LegendLuhar/Drone/README.md

# ELEC 327 Drone Final Project

This repository contains all necessary files for the ELEC 327 Final Project (Custom Drone)
