LegendLuhar/Drone/Simon_README.md

# Simon Accelerometer/Drone

Simon Accelerometer code - will be used as the skeleton for implementing basic motor actuation.
