LegendLuhar/Drone/REALdronePCB/REALdronePCB.kicad_pcb

## KiCad design REALdronePCB/REALdronePCB.kicad_pcb (2026-04-27)

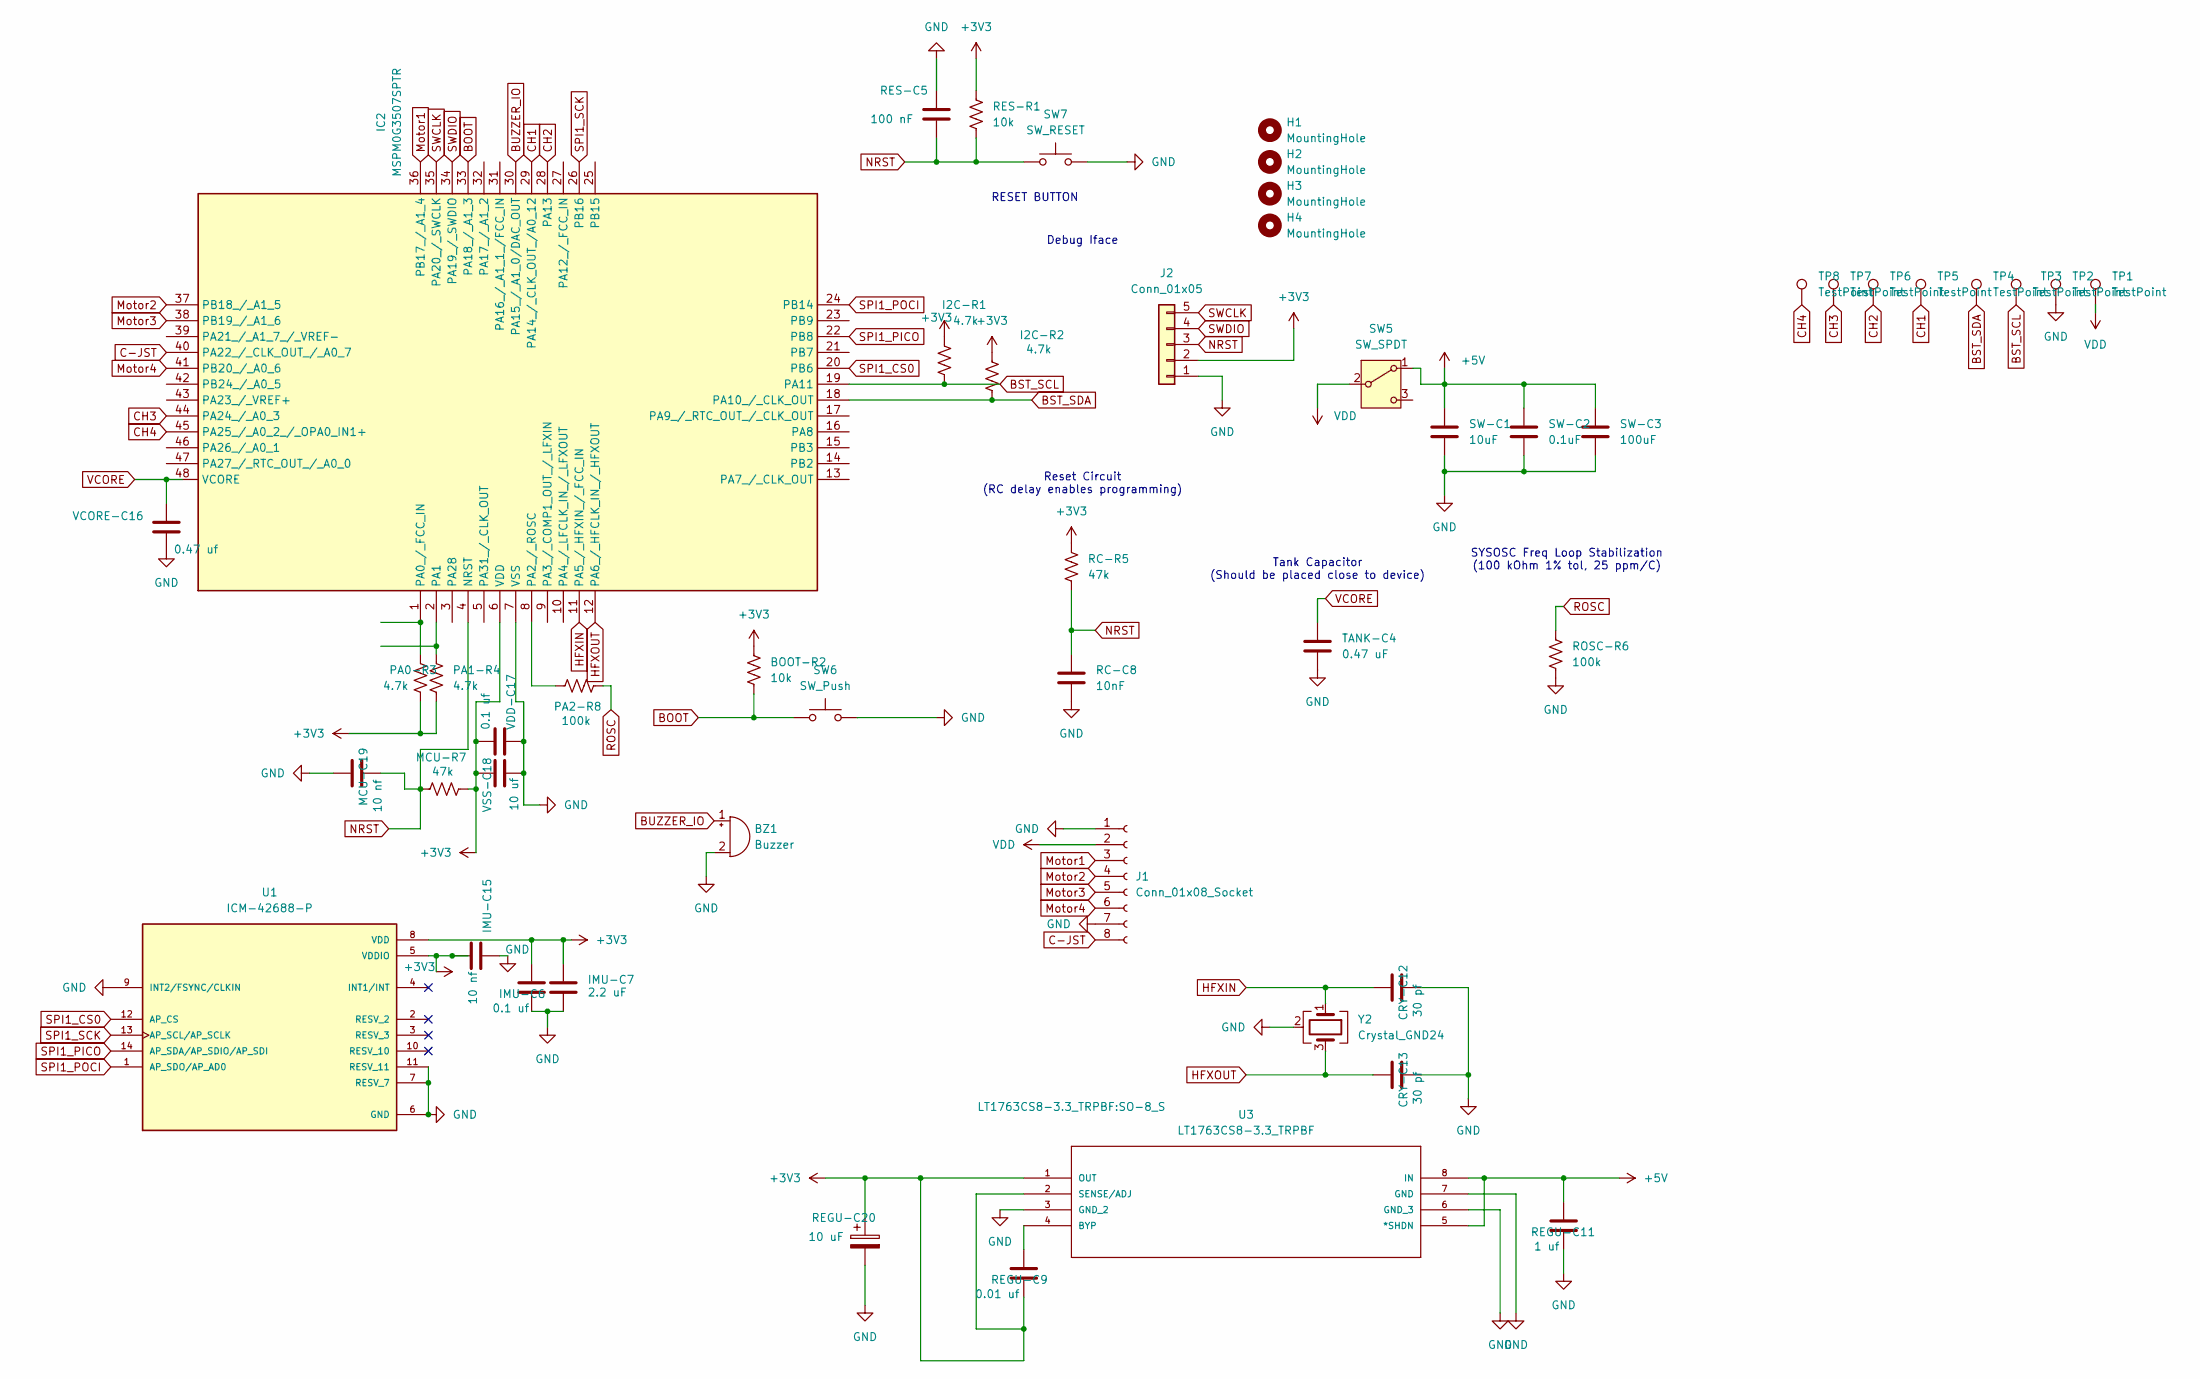
[picture p1: schematic REALdronePCB.kicad_sch]

Parts:
BOOT-R2: 10k; R_0805_2012Metric_Pad1.20x1.40mm_HandSolder
BZ1: Buzzer; Buzzer_Murata_PKLCS1212E; LCSC Part # C113159
CRY-C12, CRY-C13: 30 pf; C_1206_3216Metric_Pad1.33x1.80mm_HandSolder
H1, H2, H3, H4: MountingHole; DroneTHTPad
I2C-R1, I2C-R2: 4.7k; R_0805_2012Metric_Pad1.20x1.40mm_HandSolder; LCSC Part # C105579
IC2: MSPM0G3507SPTR; QFP50P900X900X160-48N; Mouser Part Number 595-MSPM0G3507SPTR
IMU-C6: 0.1 uf; C_1206_3216Metric_Pad1.33x1.80mm_HandSolder
IMU-C7: 2.2 uF; C_1206_3216Metric_Pad1.33x1.80mm_HandSolder
IMU-C15: 10 nf; C_1206_3216Metric_Pad1.33x1.80mm_HandSolder
J1: Conn_01x08_Socket; JST_SH_SM08B-SRSS-TB_1x08-1MP_P1.00mm_Horizontal
J2: Conn_01x05; PinHeader_1x05_P2.54mm_Horizontal; LCSC Part # C492413
MCU-C19: 10 nf; C_1206_3216Metric_Pad1.33x1.80mm_HandSolder
MCU-R7: 47k; R_0805_2012Metric_Pad1.20x1.40mm_HandSolder
PA0-R3, PA1-R4: 4.7k; R_0805_2012Metric_Pad1.20x1.40mm_HandSolder
PA2-R8: 100k; R_0805_2012Metric_Pad1.20x1.40mm_HandSolder
RC-C8: 10nF; C_1206_3216Metric_Pad1.33x1.80mm_HandSolder; LCSC Part # C15195
RC-R5: 47k; R_0805_2012Metric_Pad1.20x1.40mm_HandSolder; LCSC Part # C105579
REGU-C9: 0.01 uf; C_1206_3216Metric_Pad1.33x1.80mm_HandSolder
REGU-C11: 1 uf; C_1206_3216Metric_Pad1.33x1.80mm_HandSolder
REGU-C20: 10 uF; C_0805_2012Metric_Pad1.18x1.45mm_HandSolder
RES-C5: 100 nF; C_1206_3216Metric_Pad1.33x1.80mm_HandSolder
RES-R1: 10k; R_0805_2012Metric_Pad1.20x1.40mm_HandSolder
ROSC-R6: 100k; R_0805_2012Metric_Pad1.20x1.40mm_HandSolder; LCSC Part # C60491
SW5: SW_SPDT; SW_EG1270; MPN C20611678; LCSC Part # C20611678
SW6: SW_Push; SW_SPST_B3U-1000P
SW7: SW_RESET; SW_SPST_B3U-1000P
SW-C1: 10uF; C_0603_1608Metric; LCSC Part # C19702
SW-C2: 0.1uF; C_0603_1608Metric_Pad1.08x0.95mm_HandSolder; LCSC Part # C1591
SW-C3: 100uF; C_1206_3216Metric; LCSC Part # C15008
TANK-C4: 0.47 uF; C_1206_3216Metric_Pad1.33x1.80mm_HandSolder; LCSC Part # C13967
TP1, TP2, TP3, TP4, TP5, TP6, TP7, TP8: TestPoint; TestPoint_Pad_1.0x1.0mm
U1: ICM-42688-P; LGA-14_3x2.5mm_P0.5mm_LayoutBorder3x4y; PARTREV 1.2
U3: LT1763CS8-3.3_TRPBF; SO-8_S; MANUFACTURER_PART_NUMBER lt1763cs8
VCORE-C16: 0.47 uf; C_1206_3216Metric_Pad1.33x1.80mm_HandSolder
VDD-C17: 0.1 uf; C_1206_3216Metric_Pad1.33x1.80mm_HandSolder
VSS-C18: 10 uf; C_1206_3216Metric_Pad1.33x1.80mm_HandSolder
Y2: Crystal_GND24; Crystal_SMD_5032-4Pin_5.0x3.2mm

Connections:
+3V3: BOOT-R2.1, I2C-R1.2, I2C-R2.2, IC2.6 (VDD), IMU-C6.1, IMU-C7.1, IMU-C15.1, J2.2, MCU-R7.2, PA0-R3.2, PA1-R4.2, RC-R5.2, REGU-C9.2, REGU-C20.1, RES-R1.1, U1.5 (VDDIO), U1.8 (VDD), U3.1 (OUT), U3.2 (SENSE/ADJ), VDD-C17.1, VSS-C18.1
+5V: REGU-C11.1, SW5.1 (A), SW-C1.1, SW-C2.1, SW-C3.1, U3.5 (*SHDN), U3.8 (IN)
BOOT: BOOT-R2.2, IC2.33 (PA18_/_A1_3), SW6.1
BST_SCL: I2C-R1.1, IC2.19 (PA11), TP3.1 (1_1)
BST_SDA: I2C-R2.1, IC2.18 (PA10_/_CLK_OUT), TP4.1 (1_1)
BUZZER_IO: BZ1.1 (+), IC2.30 (PA15_/_A1_0/DAC_OUT)
C-JST: IC2.40 (PA22_/_CLK_OUT_/_A0_7), J1.8
CH1: IC2.29 (PA14_/_CLK_OUT_/A0_12), TP5.1 (1_1)
CH2: IC2.28 (PA13), TP6.1 (1_1)
CH3: IC2.44 (PA24_/_A0_3), TP7.1 (1_1)
CH4: IC2.45 (PA25_/_A0_2_/_OPA0_IN1+), TP8.1 (1_1)
GND: BZ1.2 (-), CRY-C12.2, CRY-C13.2, IC2.7 (VSS), IMU-C6.2, IMU-C7.2, IMU-C15.2, J1.1, J1.7, J2.1, MCU-C19.1, RC-C8.2, REGU-C11.2, REGU-C20.2, RES-C5.1, ROSC-R6.1, SW6.2, SW7.2, SW-C1.2, SW-C2.2, SW-C3.2, TANK-C4.2, TP2.1 (1_1), U1.6 (GND), U1.7 (RESV_7), U1.9 (INT2/FSYNC/CLKIN), U1.11 (RESV_11), U3.3 (GND_2), U3.6 (GND_3), U3.7 (GND), VCORE-C16.1, VDD-C17.2, VSS-C18.2, Y2.2 (G), Y2.4 (G)
HFXIN: CRY-C12.1, IC2.11 (PA5_/_HFXIN_/_FCC_IN), Y2.1
HFXOUT: CRY-C13.1, IC2.12 (PA6_/_HFCLK_IN_/_HFXOUT), Y2.3
Motor1: IC2.36 (PB17_/_A1_4), J1.3
Motor2: IC2.37 (PB18_/_A1_5), J1.4
Motor3: IC2.38 (PB19_/_A1_6), J1.5
Motor4: IC2.41 (PB20_/_A0_6), J1.6
NRST: IC2.4 (NRST), J2.3, MCU-C19.2, MCU-R7.1, RC-C8.1, RC-R5.1, RES-C5.2, RES-R1.2, SW7.1
unnamed: IC2.1 (PA0_/_FCC_IN), PA0-R3.1
unnamed: IC2.2 (PA1), PA1-R4.1
unnamed: IC2.8 (PA2_/_ROSC), PA2-R8.1
unnamed: REGU-C9.1, U3.4 (BYP)
ROSC: PA2-R8.2, ROSC-R6.2
SPI1_CS0: IC2.20 (PB6), U1.12 (AP_CS)
SPI1_PICO: IC2.22 (PB8), U1.14 (AP_SDA/AP_SDIO/AP_SDI)
SPI1_POCI: IC2.24 (PB14), U1.1 (AP_SDO/AP_AD0)
SPI1_SCK: IC2.26 (PB16), U1.13 (AP_SCL/AP_SCLK)
SWCLK: IC2.35 (PA20_/_SWCLK), J2.5
SWDIO: IC2.34 (PA19_/_SWDIO), J2.4
VCORE: IC2.48 (VCORE), TANK-C4.1, VCORE-C16.2
VDD: J1.2, SW5.2 (B), TP1.1 (1_1)

Notes on the sheet:
RESET BUTTON
SYSOSC Freq Loop Stabilization (100 kOhm 1% tol, 25 ppm/C)
Reset Circuit (RC delay enables programming)
Debug Iface
Tank Capacitor (Should be placed close to device)

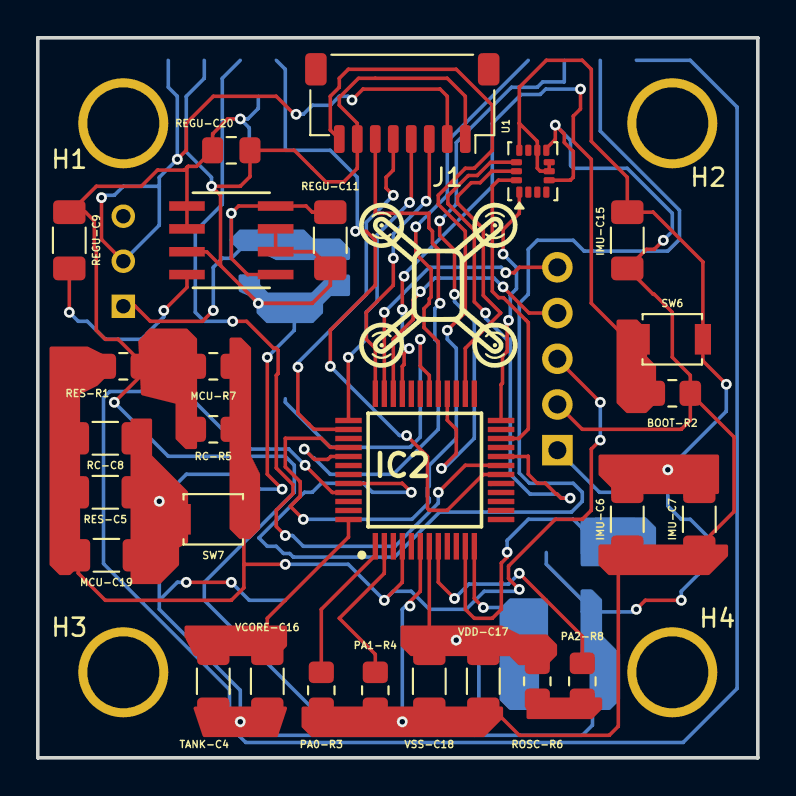
[picture p2: board REALdronePCB.kicad_pcb from above]

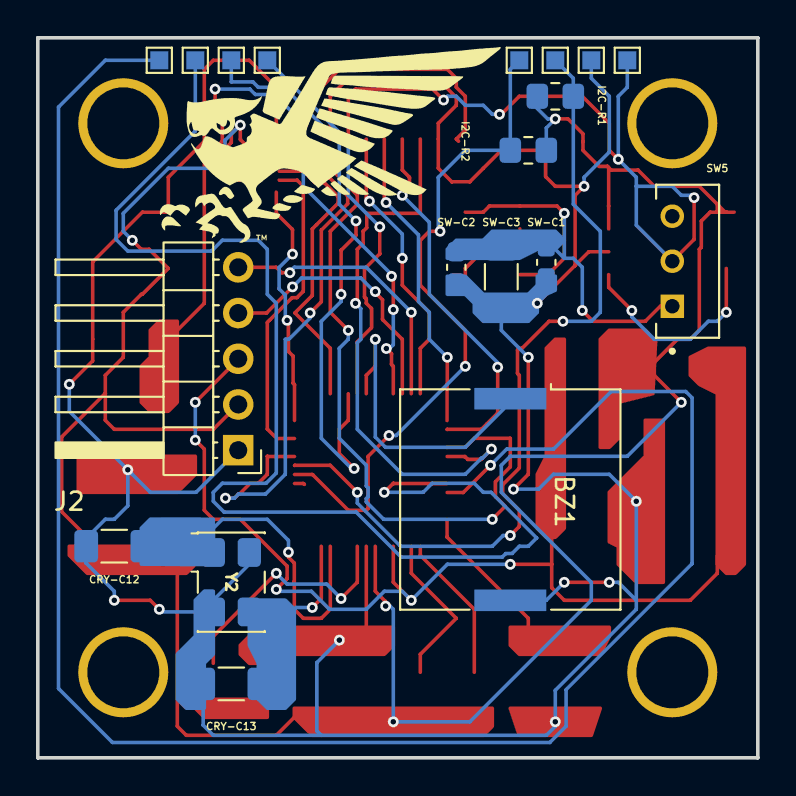
[picture p3: board REALdronePCB.kicad_pcb from below]

Board: 2 copper layers, 40.0 x 40.0 mm, 50 parts (19 on the bottom side), 32 nets.
