LegendLuhar/Drone/(commit log)

2026-04-25 PCB Added
    Should be the final rendition of the PCB
    [REALdronePCB-B_Cu.gbr, REALdronePCB-B_Mask.gbr, REALdronePCB-B_Paste.gbr, REALdronePCB-B_Silkscreen.gbr, REALdronePCB-Edge_Cuts.gbr, REALdronePCB-F_Cu.gbr, REALdronePCB-F_Mask.gbr, REALdronePCB-F_Paste.gbr]
2026-04-27 FixedPCB
    This is the final version.
    [REALdronePCB-B_Cu.gbr, REALdronePCB-B_Mask.gbr, REALdronePCB-B_Paste.gbr, REALdronePCB-B_Silkscreen.gbr, REALdronePCB-Edge_Cuts.gbr, REALdronePCB-F_Cu.gbr, REALdronePCB-F_Mask.gbr, REALdronePCB-F_Paste.gbr]
2026-04-27 Add README for Simon Accelerometer project
2026-04-27 Simon Accelerometer Project
2026-04-27 Add initial README for Simon Accelerometer project
2026-05-15 dshot motor actuation
2026-05-16 DShot improved, PWM tried but failed
    [dshot.c, dshot.h, dshot_test.c, imu.c, imu.h, pwm_test.c]
2026-05-16 Create README.md for drone firmware documentation
    Add detailed README for drone firmware project, including hardware specs, file layout, DShot driver details, and build instructions.
